SimonSchneider/nightlight/cad/stl/alternative design/esp_holder_cut.stl

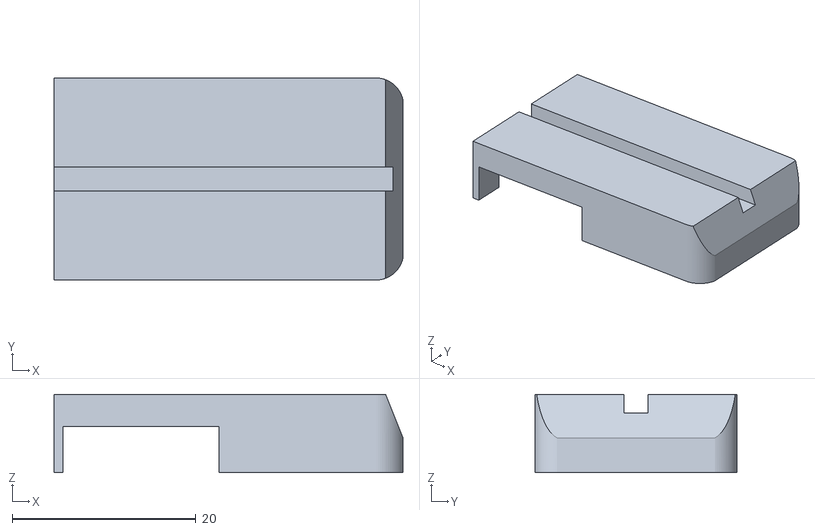
[picture p1: CAD file, 2026-08-12]
cad/stl/alternative design/esp_holder_cut.stl
38.0 x 22.0 x 8.50
