SimonSchneider/nightlight/cad/stl/body.stl

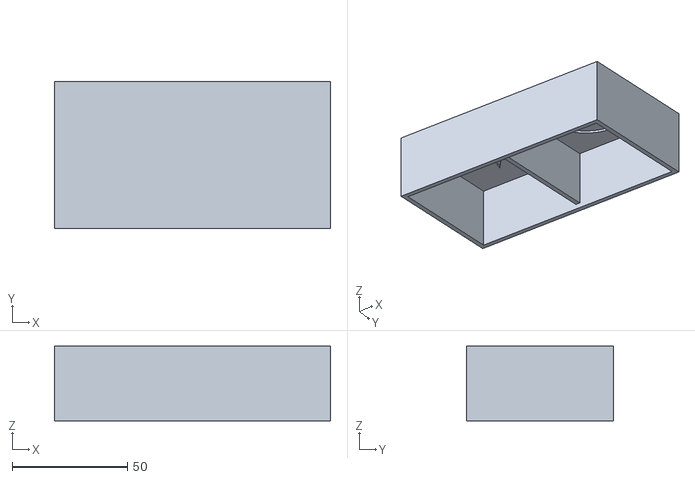
[picture p2: CAD file, 2026-08-08]
cad/stl/body.stl
120.0 x 64.0 x 32.4
