SimonSchneider/nightlight/cad/stl/alternative design/Nightlight_body.stl

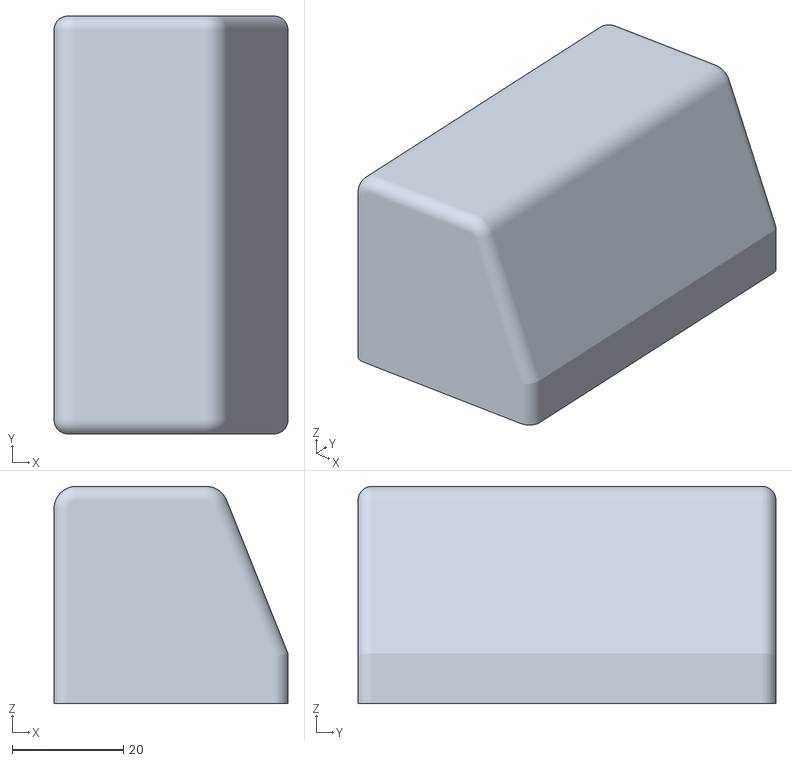
[picture p3: CAD file, 2026-08-12]
cad/stl/alternative design/Nightlight_body.stl
42.0 x 75.0 x 39.0
