SimonSchneider/nightlight/cad/stl/backplate.stl

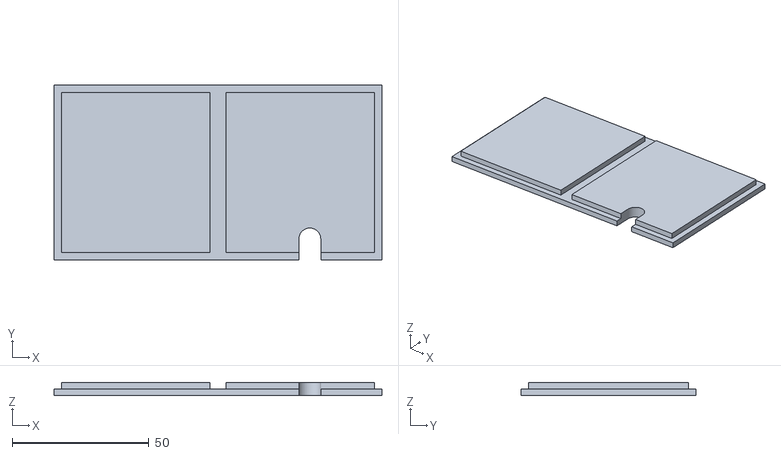
[picture p4: CAD file, 2026-08-08]
cad/stl/backplate.stl
120.0 x 64.0 x 4.80
