SimonSchneider/nightlight/cad/stl/alternative design/Nightlight_bottom.stl

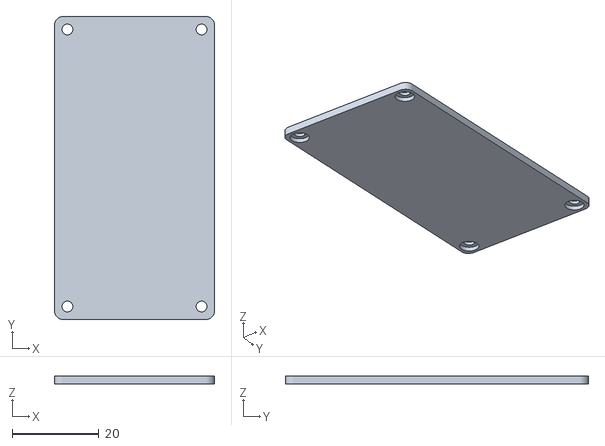
[picture p5: CAD file, 2026-08-12]
cad/stl/alternative design/Nightlight_bottom.stl
37.0 x 70.0 x 1.80
