SimonSchneider/nightlight/cad/stl/coupon.stl

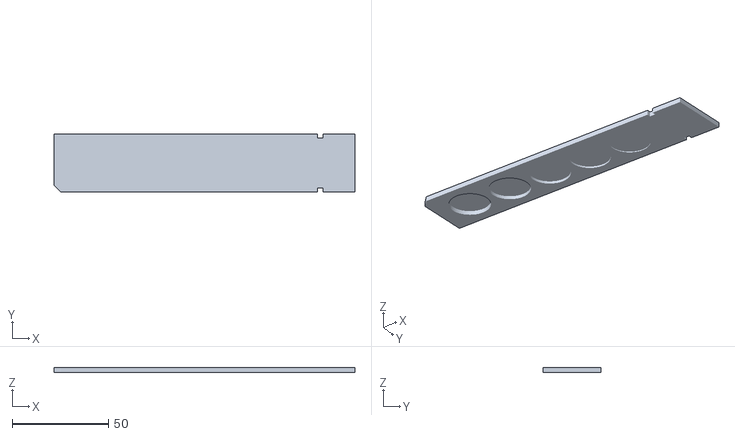
[picture p6: CAD file, 2026-08-08]
cad/stl/coupon.stl
156.0 x 30.0 x 2.40
