SimonSchneider/nightlight/(list of files, cad)

Other CAD files:
cad/body.scad
cad/icons.scad
