SimonSchneider/nightlight/(commit log)

2026-08-08 Add design spec for HA-driven day/night indicator
    Two backlit icons (sun/moon) on an ESP32-C3 with two WS2812 pixels,
    state driven entirely from Home Assistant.
    Claude-Session: https://claude.ai/code/session_01VFue4joMWWJhmzjzPHaR3f
2026-08-08 Move the ESP32-C3 inside the light enclosure
    Single integrated object (body + back plate) instead of a separate
    off-the-shelf board case. Adds an opaque third compartment for the
    board so its always-on power LED cannot leak into the night state,
    and a captive USB-C cable with a zip-tie post instead of a fitted
    port cutout, since ordered prints cannot be iterated cheaply.
    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
2026-08-08 Drop the board compartment; tape the board to the back plate
    The compartment existed only to contain the power LED's glow, which is
    fully recoverable at assembly with a scrap of opaque tape. Designing it
    out of an unrepeatable print was not warranted.
    Adds the recoverable/irrecoverable principle that decides which failures
    earn printed geometry: the sun/moon divider and the zip-tie post stay
    because neither failure can be fixed after the fact.
    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
2026-08-08 Add implementation plan; drop the printed diffuser ledge
    Nine tasks covering BOM, parametric OpenSCAD enclosure, ESPHome
    firmware, HA automations, bench test and assembly.
    Planning surfaced two defects in the spec, both fixed here:
    - The recessed diffuser ledge is geometrically impossible at these
    wall thicknesses. Retaining a disc needs a rim behind it; inserting
    one from behind needs an opening larger than the disc. A paper
    diffuser is a recoverable failure, so it is taped in at assembly.
    - ESPHome's template switch fires turn_on_action before publishing
    its state, so an action reading switch.is_on would have shown the
    wrong icon on every toggle. The switch now calls show_nigh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
2026-08-08 Use installed OpenSCAD 2026.06.12; add CAD review gate
    OpenSCAD is already on PATH, so drop the install step. This version
    uses the Manifold backend, which repairs some defects silently, so
    the geometry checks now lean on visual inspection and STL file size
    rather than on an empty warning log.
    Adds an explicit human review gate before ordering prints.
    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
2026-08-08 docs: add bill of materials and wiring
2026-08-08 cad: add parameters and sun/moon icon profiles
    [icons.scad, params.scad]
2026-08-08 cad: add enclosure body with icon windows and light divider
    Open-backed box with a solid front wall thinned from behind to face_t
    at each icon aperture, and a full-depth divider sealing the sun and
    moon chambers from each other. Verified via render, STL export, an
    inner-face render (icon windows are invisible from an opaque exterior
    render by design, so checked from the back), and a thin-slice
    cross-section confirming the divider runs unbroken from the front wall
    to the open back edge.
    [body.scad]
2026-08-08 plan: correct Task 3 render expectations
    The front face is smooth; icons are cut from inside, so an unlit icon
    is invisible. Adds an inner-face render, and replaces the oblique
    section camera with a straight-on orthographic one.
    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
2026-08-08 cad: add back plate with captive cable entry and zip-tie post
    [backplate.scad]
2026-08-08 cad: add render script and export print-ready STLs
    [backplate.stl, body.stl]
2026-08-08 cad: open the cable entry to the plate edge, fix unassemblable design
    The closed 8 mm round cable_hole_d could not pass a USB-C plug at
    either end, making the documented assembly step physically
    impossible. Replace it with a U-shaped slot (hull of two cylinders)
    open to the -Y plate edge, so the cable drops in sideways. The
    existing zip-tie post, unchanged, still retains it; edge-to-edge gap
    between slot and post is 1.32 mm, no intersection.
    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
    [backplate.scad, backplate.stl, params.scad]
2026-08-08 Fix lip clearance: increase from 0.3 to 0.6 mm total
    This provides 0.3 mm per-side gap against the body cavity (115.2 x 59.2 mm),
    giving a lip of 114.6 x 58.6 mm. Previous 0.3 mm clearance was too tight
    (only 0.15 mm per side) for FDM prints from a service.
    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
    [backplate.stl, params.scad]
2026-08-08 cad: remove zip-tie post from back plate, move strain relief to assembly
    The device lives on a high shelf out of reach, so the printed post is
    unnecessary geometry. An overhand knot tied in the USB-C cable inside
    the enclosure is wider than the 8 mm slot and cannot pull back through
    it, giving the same strain relief at zero print cost. Renames
    backplate_with_holes() to backplate_with_slot() now that it cuts a
    single slot, and drops the now-unused post_h/post_d/post_slot_w
    params and their assertion.
    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
    [backplate.scad, backplate.stl, params.scad]
2026-08-08 docs: record cable-slot, lip-clearance and post-removal revisions
    Plan gains a Revisions section and marks the superseded Task 2/4 code
    blocks; Task 9 assembly now specifies the knot. Spec's power-entry
    section records why the closed hole was a live defect.
    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
2026-08-08 fix: close the enclosure, route the sun pixel's wires, correct the BOM
    Final pre-order review fixes. The enclosure as committed could not close and
    the sun pixel could not be wired at all.
    C1 — lip and divider collided. body.scad built the divider flush with the open
    back (z -13.7..+11.3); the back plate's lip drops into that same volume for
    backplate_t. Measured overlap between the two committed STLs: 337.536 mm^3
    (2.4 x 58.6 x 2.4), which would have held the plate 2.4 mm proud all round.
    The divider now stops at the lip's top face plus a named divider_gap = 0.2:
    front face = body_d/2 - wall = 11.3 (unchanged)
    rear face = -body_d/2 + backplate_t + divider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
    [backplate.scad, backplate.stl, body.scad, body.stl, params.scad]
2026-08-08 fix(homeassistant): correct switch entity_id in automations.yaml
    friendly_name is set in firmware/daynight.yaml, which triggers ESPHome's
    has_entity_name semantics: HA combines the friendly device name with each
    entity's own name to build entity_id, not the raw name: slug. Per HA's
    ESPHome integration docs this yields switch.day_night_indicator_night_mode
    for the night_mode switch, not switch.daynight_night_mode as previously
    targeted — the old value would have made all three automations silently
    no-op against a nonexistent entity. Also expands the header comment with
    verification steps and both candidate ids, since entity_ids are assigned
    once at first registration and won't auto-migrate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
2026-08-08 Split night_mode into independent sun and moon switches
    One switch meant the sun burned at 80% from wake-up until bedtime.
    Two switches, one per icon, add the state the single switch could not
    express: both dark, which is now the ordinary daytime state.
    Mutual exclusion stays in firmware rather than moving to Home Assistant:
    each turn_on_action extinguishes the other icon and clears the other
    switch with publish_state(false) via a lambda, not switch.turn_off, so
    the two switches cannot trigger each other's actions in a loop. The
    invariant relaxes from "exactly one lit" to "at most one lit"; both lit
    remains unreachable. If both switches restore ON at boot, the moon wins.
    Both partition lig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
    [daynight.yaml]
2026-08-08 docs: explain cutting the pixels, and warn 5V vs 12V strip
    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
2026-08-08 Fix boot tiebreak, self-heal a stuck moon, and correct the build notes
    The firmware claimed the moon wins if both switches restore ON from flash.
    It did not. TemplateSwitch::setup() applies the restored state through
    write_state(), which fires turn_on_action at setup time, before the on_boot
    priority -100 handler runs. Equal setup priorities are ordered by declaration,
    so the switch declared second runs last and wins — and moon_icon was declared
    first, leaving the sun lit at 3am. Swap the two blocks so sun_icon is first
    and the moon genuinely wins, and document why the order is load-bearing.
    apply_state's tiebreak is unchanged and remains the steady-state path.
    The 08:30 automation turned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
    [daynight.yaml]
2026-08-08 plan: record the two-switch model and entity ID derivation
    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
2026-08-08 docs: specify IP30 strip — silicone-coated pads cannot be cut and soldered cleanly
    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
2026-08-08 cad: add diffuser test coupon
    face_t is the one dimension that cannot be adjusted after assembly, and
    whether 1.2 mm is right depends on filament pigment loading and room
    brightness rather than on anything calculable. Since the print is now
    being done on a friend's printer rather than ordered, measuring beats
    reasoning: five windows at 0.4-2.0 mm, ~9 g, 20 minutes.
    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
    [coupon.scad, coupon.stl]
2026-08-08 cad: add solid wall-thickness sample to the diffuser coupon
    The coupon tested only transmission. The design also depends on the
    opposite property: 2.4 mm walls and divider must BLOCK light, or the
    whole panel glows instead of the icon. Adds sample 6 at full wall
    thickness, solid, marked with edge ticks since it has no recess.
    Worst case for that check is the sun at 80% in a dark room, not the
    night state — documented accordingly.
    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
    [coupon.scad, coupon.stl]
2026-08-08 docs: correct the fix for a glowing wall sample
    Earlier text said a translucent wall means buying a different spool.
    That was wrong: lining the chamber walls with opaque tape or paint is
    an assembly fix, and the walls are flat and fully accessible. Also
    records why doubling thickness roughly squares transmission, so the
    icon/wall contrast is inherent to the geometry rather than a property
    of the particular filament.
    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
2026-08-08 firmware: make the sun yellow, with a tunable hue
    The sun was warm white (R100/G85/B60). RGB "white" is three narrow
    spectral spikes with gaps where cyan and amber should be, so it reads
    bluish and harsh. The obvious fix is an SK6812 RGBW strip with a real
    warm-white die; that is rejected here in favour of a yellow sun.
    A yellow sun is the better symbol — children draw suns yellow — and it
    costs almost no perceived brightness, since green dominates luminance
    and blue contributes little. It also embraces what the hardware was
    already doing: blue has the highest forward voltage of the three dies,
    so on the deliberately-chosen 3.3 V rail it was the most starved
    channel and the white was al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
    [daynight.yaml]
2026-08-08 cad: raise chamber depth 25 -> 40 mm for even diffusion
    Coupon testing showed 20-30 mm of standoff is needed for even
    diffusion behind a 20 mm window. The largest continuous lit area in
    the real panel is the sun's 24 mm core disc, so 40 mm gives a
    standoff/aperture ratio of ~1.7 there — past what was measured.
    Body grows 27.4 -> 42.4 mm deep and 51.7 -> 70.4 g. Verified the
    parts still mate with zero interference at the new depth, with a
    1 mm mis-seat control proving the check detects collisions.
    Costs light: illuminance falls with the square of standoff, so this
    keeps ~39% of what 25 mm delivered. Documented so brightness is
    judged on the coupon at the real 40 mm, not closer.
    Co-Author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
    [body.stl, params.scad]
2026-08-08 cad: chamber depth 30 mm rather than 40
    30 mm gives a standoff/aperture ratio of 1.25 on the sun's 24 mm core
    disc — the largest continuous lit area, since the rays are thin and the
    moon is a ~13 mm crescent — which is inside the 20-30 mm range coupon
    testing established.
    Prefers light over extra evenness: illuminance falls with the square of
    standoff, so 30 mm puts ~78% more on the face than 40 mm. The sun has
    to compete with a lit room.
    Body 42.4 -> 32.4 mm deep, 70.4 -> 57.9 g. Mating re-verified at zero
    interference, with a 1 mm mis-seat control returning 841 mm3.
    Claude-Session: https://claude.ai/code/session_01VF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
    [body.stl, params.scad]
2026-08-12 Adding STL files for other design
    [Nightlight_body.stl, Nightlight_bottom.stl, esp_holder_cut.stl]
2026-08-12 feat: add WiFi nightlight firmware with LED control and NTP synchronization
2026-08-15 firmware: add Arduino bring-up blink test
    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
2026-08-15 firmware: ESPHome port of the standalone NTP nightlight
    Ports wifi_nightlight.ino so it can be flashed and updated from the
    Home Assistant ESPHome add-on. Logic is unchanged: the device keeps
    its own clock and decides for itself; HA is only the build tool and a
    place to tune brightness.
    Re-derives state from the clock every 30 s rather than using on_time
    triggers. on_time fires only at the instant a boundary passes, so a
    device booting or waiting on NTP at 06:30 misses it and burns the moon
    through breakfast with no recovery. The periodic check is self-healing
    and mirrors what the Arduino loop() already did.
    Deliberately opposite to daynight.yaml, which has no clock and takes
    orders from H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
    [nightlight.yaml]
2026-08-15 firmware: drop the ESPHome blink test
    Superseded by firmware/arduino/blink_test/blink_test.ino for bench use;
    the ESPHome equivalent is a throwaway that does not need to live here.
    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
2026-08-15 firmware: make icon transitions instant
    The 20 s crossfade came from a brainstorm idea that a child would catch
    the change happening. Nobody is watching at 06:30:00, while every manual
    toggle and brightness tweak felt broken — and during bring-up it made
    'nothing happened yet' indistinguishable from 'the firmware is dead'.
    Fade time is now a single 'transition' substitution at the top of each
    firmware, so 1s is one edit away if the moon going out in a dark room
    reads as too abrupt.
    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
    [daynight.yaml, nightlight.yaml]
2026-08-15 firmware: fix boot crash loop in the light path
    Store access fault inside AddressableLight::schedule_show() — a write
    through a not-yet-valid pointer, i.e. the LEDs were driven before the
    light stack was safe to call.
    Three plausible causes, all removed:
    - on_time_sync fired apply_schedule, and the SNTP callback path may not
    be deferred to the main loop; light calls off-task corrupt state.
    Dropped; the tick now runs every 10 s instead of 30 s, so the display
    still settles within seconds of NTP landing.
    - The number entities restore during their own setup() and fire
    on_value, driving the lights mid-boot. Added a 'booted' global, set
    last in on_boot (priority -100), that every re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
    [daynight.yaml, nightlight.yaml]
2026-08-15 firmware: stop apply_state stopping itself
    The booted guard was implemented as script.stop: apply_state from
    inside apply_state, which mutates the state machine currently running
    that script — a fault source in its own right, introduced by the fix
    for the previous fault.
    Replaced with a plain nested condition. No script.stop anywhere.
    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
    [daynight.yaml]
